fuszenecker/Project1/README.md

# Project1

Project 1 in Kandó College (2007)
Switching mode power supply with ARM microcontroller and Linux.
