fuszenecker/Project1/Prez.pdf

Bevezetés | Hardver | Fejlesztői környezet | Felhasználói felületek | Utószó

## Kapcsoló üzemű tápegység megvalósítása ARM alapú mikrovezérlővel és Linux-szal

Fuszenecker Róbert

Budapesti Műszaki Főiskola Kandó Kálmán Műszaki Főiskolai Kar

2007. december 5.

Fuszenecker Róbert | BMF KKMFK (2007.)

Kapcsoló üzemű tápegység megvalósítása ARM alapú mikrovezérlővel és Linux-szal

## A tápegység főbb tulajdonságai

I Szekunder oldali kapcsoló üzemű működés
I Maximális bemenő feszültség: 16 V
I Kimeneti feszültségtartomány: 0 – 16 V
I Maximális kimenő áram: 1 A (szoftveres áramhatárolással) I 3 db független csatorna
I ARM7TDMI processzor (32 bites)
I Hálózatba szervezhető (RS-232 gyűrű)

## A tápegység főbb tulajdonságai

I Szekunder oldali kapcsoló üzemű működés
I Maximális bemenő feszültség: 16 V
I Kimeneti feszültségtartomány: 0 – 16 V
I Maximális kimenő áram: 1 A (szoftveres áramhatárolással) I 3 db független csatorna
I ARM7TDMI processzor (32 bites)
I Hálózatba szervezhető (RS-232 gyűrű)

## A tápegység főbb tulajdonságai

I Szekunder oldali kapcsoló üzemű működés
I Maximális bemenő feszültség: 16 V
I Kimeneti feszültségtartomány: 0 – 16 V
I Maximális kimenő áram: 1 A (szoftveres áramhatárolással) I 3 db független csatorna
I ARM7TDMI processzor (32 bites)
I Hálózatba szervezhető (RS-232 gyűrű)

## A tápegység főbb tulajdonságai

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

## A tápegység főbb tulajdonságai

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

## A tápegység főbb tulajdonságai

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

## A tápegység főbb tulajdonságai

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

## Hálózat

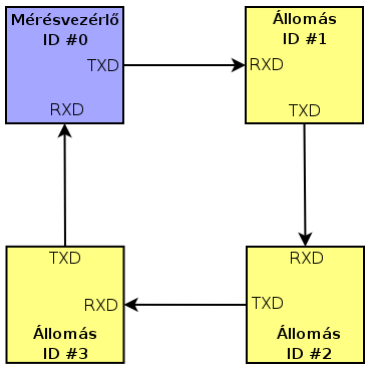
[picture p9: figure]

## A mérőhálózat és a berendezések főbb összetevői

I Mérésvezérlő: személyi számítógép Linux-szal és a megfelelő működtető szoftverrel
I Műszerek felépítése:
I | Processzor modul (mikrovezérlő és kisegítő áramkörei), ez
| tartja a kapcsolatot a mérésvezérlővel
I | Végrehajtó, beavatkozó és érzékelő szerveket tartalmazó modul

## A mérőhálózat és a berendezések főbb összetevői

I Mérésvezérlő: személyi számítógép Linux-szal és a megfelelő működtető szoftverrel
I Műszerek felépítése:
I | Processzor modul (mikrovezérlő és kisegítő áramkörei), ez
| tartja a kapcsolatot a mérésvezérlővel
I | Végrehajtó, beavatkozó és érzékelő szerveket tartalmazó modul

## A mérőhálózat és a berendezések főbb összetevői

I Mérésvezérlő: személyi számítógép Linux-szal és a megfelelő működtető szoftverrel
I Műszerek felépítése:
I | Processzor modul (mikrovezérlő és kisegítő áramkörei), ez
| tartja a kapcsolatot a mérésvezérlővel
I | Végrehajtó, beavatkozó és érzékelő szerveket tartalmazó modul

## A mérőhálózat és a berendezések főbb összetevői

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

## A mérőberendezés blokkvázlata

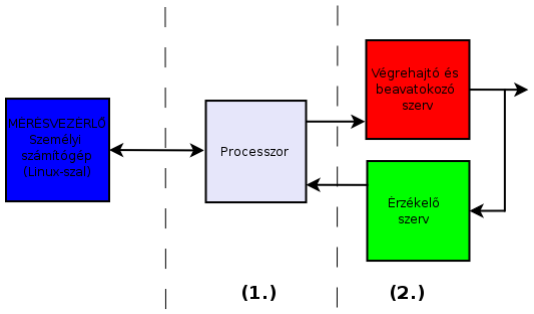
[picture p10: figure]

## Elvárások a mérésvezérlővel szemben

I Operációs rendszer (Linux) és működtető (felhasználói) szoftver
I Párhuzamos (nyomtató) vagy USB csatlakozó a JTAG-hez I Soros port vagy USB → soros port átalakító

A működtető szoftverről még a „Fejlesztői környezet” részben lesz szó.

## Elvárások a mérésvezérlővel szemben

I Operációs rendszer (Linux) és működtető (felhasználói) szoftver
I Párhuzamos (nyomtató) vagy USB csatlakozó a JTAG-hez I Soros port vagy USB → soros port átalakító

A működtető szoftverről még a „Fejlesztői környezet” részben lesz szó.

## Elvárások a mérésvezérlővel szemben

I Operációs rendszer (Linux) és működtető (felhasználói) szoftver
I Párhuzamos (nyomtató) vagy USB csatlakozó a JTAG-hez I Soros port vagy USB → soros port átalakító

A működtető szoftverről még a „Fejlesztői környezet” részben lesz szó.

## Elvárások a mérésvezérlővel szemben

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

A működtető szoftverről még a „Fejlesztői környezet” részben lesz szó.

## Az ARM alapú mikrovezérlők

I Eredetileg az ARM magot processzorok számára fejlesztették ki (Acorn PC-k, Apple iPod, Intel PDA-k)
I Mára a mikrovezérlő-gyártók kedvelt processzora lett
I | 32 bites aritmetikai egységgel rendelkezik
I | 4 GBájt lineáris címtartomány
I | Kis fogyasztás (29,4 mA áramfelvétel 50 MHz-es
| órajelfrekvencián)
I | A gyártók nagyszámú külső eszközzel egészítették ki, így
| alakult ki a mikrovezérlő, az egy lapkán felépített
| számítógép

## Az ARM alapú mikrovezérlők

I Eredetileg az ARM magot processzorok számára fejlesztették ki (Acorn PC-k, Apple iPod, Intel PDA-k)
I Mára a mikrovezérlő-gyártók kedvelt processzora lett
I | 32 bites aritmetikai egységgel rendelkezik
I | 4 GBájt lineáris címtartomány
I | Kis fogyasztás (29,4 mA áramfelvétel 50 MHz-es
| órajelfrekvencián)
I | A gyártók nagyszámú külső eszközzel egészítették ki, így
| alakult ki a mikrovezérlő, az egy lapkán felépített
| számítógép

## Az ARM alapú mikrovezérlők

I Eredetileg az ARM magot processzorok számára fejlesztették ki (Acorn PC-k, Apple iPod, Intel PDA-k)
I Mára a mikrovezérlő-gyártók kedvelt processzora lett
I | 32 bites aritmetikai egységgel rendelkezik
I | 4 GBájt lineáris címtartomány
I | Kis fogyasztás (29,4 mA áramfelvétel 50 MHz-es
| órajelfrekvencián)
I | A gyártók nagyszámú külső eszközzel egészítették ki, így
| alakult ki a mikrovezérlő, az egy lapkán felépített
| számítógép

## Az ARM alapú mikrovezérlők

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

## Az ARM alapú mikrovezérlők

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

## Az ARM alapú mikrovezérlők

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

## Az ARM alapú mikrovezérlők kiegészítő elemei

I FLASH és RAM memória (8-512 kbájt)
I Analóg–digitális és digitális–analóg átalakító (10 bites)
I 16 és 32 bites számlálók (események számlálására, időzítésre, PWM-re)
I SPI: Serial Peripheral Interface, MMC és SD kártyák programozására
I Megszakításvezérlő
I Órajel-generátor

I GPIO: általános célú (digitális) adatbemenetek és kimenetek I RTC: valós idejű óra
I WDT: watchdog timer

## Az ARM alapú mikrovezérlők kiegészítő elemei

I FLASH és RAM memória (8-512 kbájt)
I Analóg–digitális és digitális–analóg átalakító (10 bites)
I 16 és 32 bites számlálók (események számlálására, időzítésre, PWM-re)
I SPI: Serial Peripheral Interface, MMC és SD kártyák programozására
I Megszakításvezérlő
I Órajel-generátor

I GPIO: általános célú (digitális) adatbemenetek és kimenetek I RTC: valós idejű óra
I WDT: watchdog timer

## Az ARM alapú mikrovezérlők kiegészítő elemei

I FLASH és RAM memória (8-512 kbájt)
I Analóg–digitális és digitális–analóg átalakító (10 bites)
I 16 és 32 bites számlálók (események számlálására, időzítésre, PWM-re)
I SPI: Serial Peripheral Interface, MMC és SD kártyák programozására
I Megszakításvezérlő
I Órajel-generátor

I GPIO: általános célú (digitális) adatbemenetek és kimenetek I RTC: valós idejű óra
I WDT: watchdog timer

## Az ARM alapú mikrovezérlők kiegészítő elemei

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

## Az ARM alapú mikrovezérlők kiegészítő elemei

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

## Az ARM alapú mikrovezérlők kiegészítő elemei

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

## Az ARM alapú mikrovezérlők kiegészítő elemei

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

## Az ARM alapú mikrovezérlők kiegészítő elemei

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

## Az ARM alapú mikrovezérlők kiegészítő elemei

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

## Az ARM alapú mikrovezérlők kiegészítő elemei (folytatás)

I U(S)ART: univerzális aszinkron (soros) adó-vevő; ezt fogjuk a számítógéppel való kommunikációhoz használni
I USB: univerzális soros busz
I Ethernet
I CAN és LIN busz: mikrovezérlők helyi hálózatba kötésére

## Az ARM alapú mikrovezérlők kiegészítő elemei (folytatás)

I U(S)ART: univerzális aszinkron (soros) adó-vevő; ezt fogjuk a számítógéppel való kommunikációhoz használni
I USB: univerzális soros busz
I Ethernet
I CAN és LIN busz: mikrovezérlők helyi hálózatba kötésére

## Az ARM alapú mikrovezérlők kiegészítő elemei (folytatás)

I U(S)ART: univerzális aszinkron (soros) adó-vevő; ezt fogjuk a számítógéppel való kommunikációhoz használni
I USB: univerzális soros busz
I Ethernet
I CAN és LIN busz: mikrovezérlők helyi hálózatba kötésére

## Az ARM alapú mikrovezérlők kiegészítő elemei (folytatás)

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

## A választás

A tápegység megépítéséhez az ATMEL cég AT91SAM7S64 típusú mikrovezérlőjét használtam.

## A processzor modul

A processzor modul tartalmaz
I stabilizált, túlfeszültség ellen védett tápegységet, max. 15 V bemenő feszültségig
I nagypontosságú órajelforrást a pontos időzítésekhez, aszinkron soros átvitelhez
I a JTAG kivezetéseket, 10 pólusú szalagkábel csatlakozón keresztül
I a megfelelő üzemmódba lépést beállító kapocspárt (nyomkövetés vagy normál üzem)
I hardver RESET kivezetést a mikrovezérlő esetleges kézi újraindításához
I LED-eket a hibás és megfelelő állapotok jerlzésére

## A processzor modul

A processzor modul tartalmaz
I stabilizált, túlfeszültség ellen védett tápegységet, max. 15 V bemenő feszültségig
I nagypontosságú órajelforrást a pontos időzítésekhez, aszinkron soros átvitelhez
I a JTAG kivezetéseket, 10 pólusú szalagkábel csatlakozón keresztül
I a megfelelő üzemmódba lépést beállító kapocspárt (nyomkövetés vagy normál üzem)
I hardver RESET kivezetést a mikrovezérlő esetleges kézi újraindításához
I LED-eket a hibás és megfelelő állapotok jerlzésére

## A processzor modul

A processzor modul tartalmaz
I stabilizált, túlfeszültség ellen védett tápegységet, max. 15 V bemenő feszültségig
I nagypontosságú órajelforrást a pontos időzítésekhez, aszinkron soros átvitelhez
I a JTAG kivezetéseket, 10 pólusú szalagkábel csatlakozón keresztül
I a megfelelő üzemmódba lépést beállító kapocspárt (nyomkövetés vagy normál üzem)
I hardver RESET kivezetést a mikrovezérlő esetleges kézi újraindításához
I LED-eket a hibás és megfelelő állapotok jerlzésére

## A processzor modul

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

## A processzor modul

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

## A processzor modul

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

## A processzor modul

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

## A processzor modul

A processzor modull tartalmaz (folytatás)
I (Token Ring–)RS-232 kommunikációt lehetővé tevő kivezetéseket és illesztő áramköröket
I 4 pólusú szalagkábel csatlakozóra kivezetett ki- és bemeneteket:
I | 3 db PWM kimenet
I | 2 × 3 db analóg bemenet
I | 3 × 2 db LED kimenet (előlapra kivezetve)

## A processzor modul

A processzor modull tartalmaz (folytatás)
I (Token Ring–)RS-232 kommunikációt lehetővé tevő kivezetéseket és illesztő áramköröket
I 4 pólusú szalagkábel csatlakozóra kivezetett ki- és bemeneteket:
I | 3 db PWM kimenet
I | 2 × 3 db analóg bemenet
I | 3 × 2 db LED kimenet (előlapra kivezetve)

## A processzor modul

A processzor modull tartalmaz (folytatás)
I (Token Ring–)RS-232 kommunikációt lehetővé tevő kivezetéseket és illesztő áramköröket
I 4 pólusú szalagkábel csatlakozóra kivezetett ki- és bemeneteket:
I | 3 db PWM kimenet
I | 2 × 3 db analóg bemenet
I | 3 × 2 db LED kimenet (előlapra kivezetve)

## A processzor modul

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

## A processzor modul

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

## A processzor modul

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

## A processzor modul kapcsolási rajza

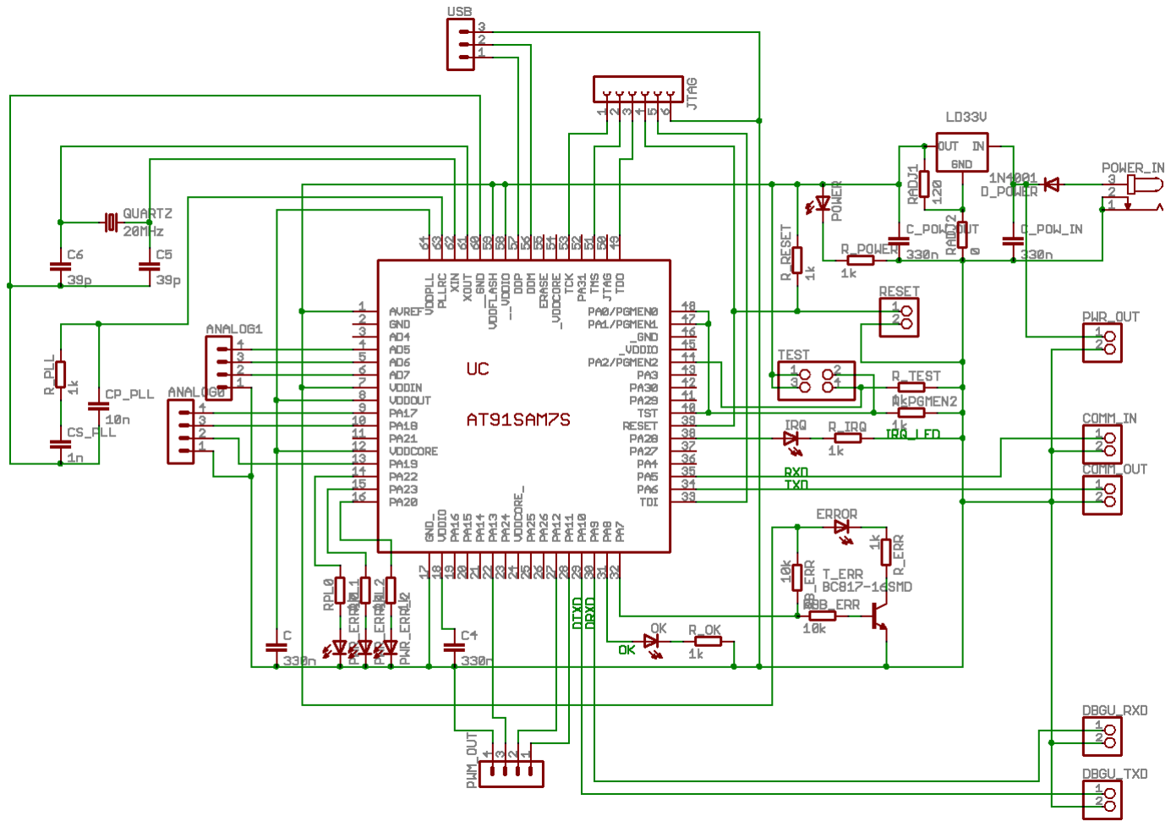
[picture p11: figure]

## A processzor modul NYÁK-rajza


## Érzékelő, végrehajtó és beavatkozó szervek

A modulon kaptak helyet
I A kapcsolóeszközök (PWM jellel vezérelve)
I Kimenő jelek mérésére szolgáló elemek (A/D átalakító segítségével, túlfeszültség-védetten)

## Érzékelő, végrehajtó és beavatkozó szervek

A modulon kaptak helyet
I A kapcsolóeszközök (PWM jellel vezérelve)
I Kimenő jelek mérésére szolgáló elemek (A/D átalakító segítségével, túlfeszültség-védetten)

## Érzékelő, végrehajtó és beavatkozó szervek

A modulon kaptak helyet
I A kapcsolóeszközök (PWM jellel vezérelve)
I Kimenő jelek mérésére szolgáló elemek (A/D átalakító segítségével, túlfeszültség-védetten)

## A végrehajtó-érzékelő modul kapcsolási rajza

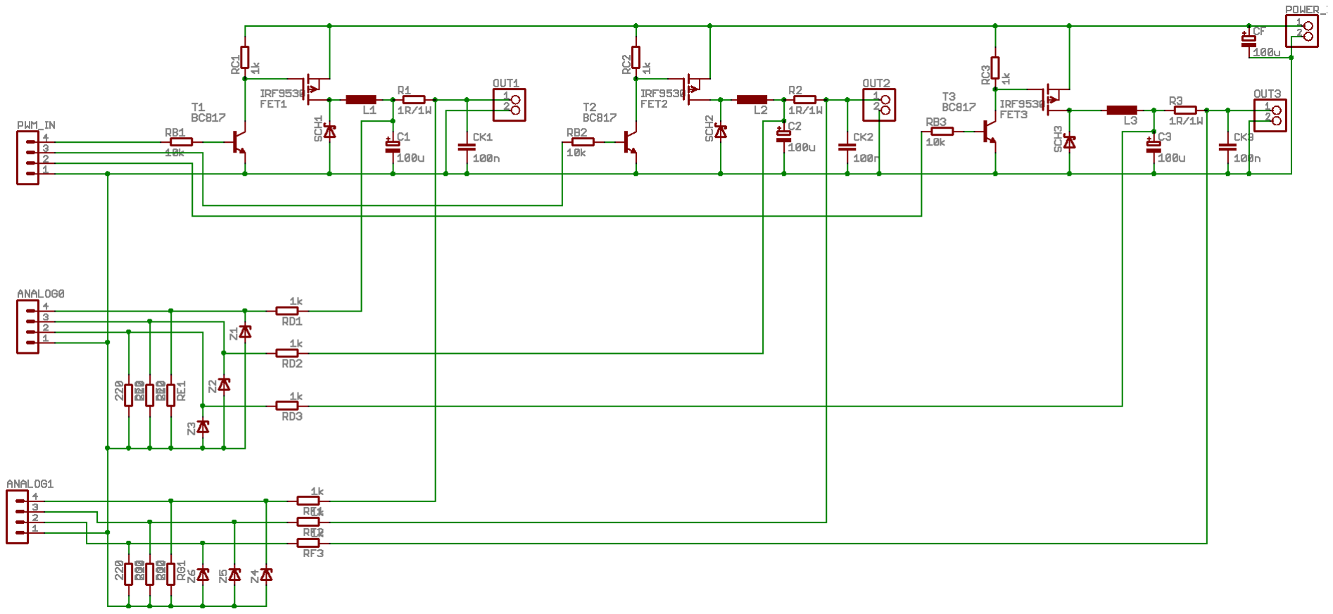
[picture p12: figure]

## A végrehajtó-érzékelő modul NYÁK-rajza


## A fejlesztői környezet

A számítógép működtető szoftverének, és a mikrovezérlő programjának elkészítéséhez szükségesek a következő komponensek:¹

I binutils, gcc és gdb: a számítógép számára fordítanak, ezekkel készül a mérésvezérlő szoftvere
I binutils, gcc és gdb: ARM architektúrára fordítanak; segítségükkel állítjuk elő a mikrovezérlő programját (firmware) I OpenOCD: a számítógépen fut, feltöltő és nyomkövető program

1Erről részletesen a dolgozatban olvashatunk

## A fejlesztői környezet

A számítógép működtető szoftverének, és a mikrovezérlő programjának elkészítéséhez szükségesek a következő komponensek:¹

I binutils, gcc és gdb: a számítógép számára fordítanak, ezekkel készül a mérésvezérlő szoftvere
I binutils, gcc és gdb: ARM architektúrára fordítanak; segítségükkel állítjuk elő a mikrovezérlő programját (firmware) I OpenOCD: a számítógépen fut, feltöltő és nyomkövető program

1Erről részletesen a dolgozatban olvashatunk

## A fejlesztői környezet

A számítógép működtető szoftverének, és a mikrovezérlő programjának elkészítéséhez szükségesek a következő komponensek:¹

I binutils, gcc és gdb: a számítógép számára fordítanak, ezekkel készül a mérésvezérlő szoftvere
I binutils, gcc és gdb: ARM architektúrára fordítanak; segítségükkel állítjuk elő a mikrovezérlő programját (firmware) I OpenOCD: a számítógépen fut, feltöltő és nyomkövető program

1Erről részletesen a dolgozatban olvashatunk

## A fejlesztői környezet

A számítógép működtető szoftverének, és a mikrovezérlő programjának elkészítéséhez szükségesek a következő komponensek:¹

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

1Erről részletesen a dolgozatban olvashatunk

## Adatátvitel soros porton keresztül

A számítógép és a mikrovezérlő között az átvitel bájtsoros és csomagorientált. Tulajdonságai:
I Több eszköz (mérésvezérlő és mérőberendezések) kapcsolható rendszerbe
I Fix csomagméret, előre definiált parancsok
I Nincs szükség statikus eszközazonosítókra, ezeket a mérésvezérlő osztja ki
I Hibavédelemmel ellátott a kommunikáció (8 bites ellenőrző összeg)

## Adatátvitel soros porton keresztül

A számítógép és a mikrovezérlő között az átvitel bájtsoros és csomagorientált. Tulajdonságai:
I Több eszköz (mérésvezérlő és mérőberendezések) kapcsolható rendszerbe
I Fix csomagméret, előre definiált parancsok
I Nincs szükség statikus eszközazonosítókra, ezeket a mérésvezérlő osztja ki
I Hibavédelemmel ellátott a kommunikáció (8 bites ellenőrző összeg)

## Adatátvitel soros porton keresztül

A számítógép és a mikrovezérlő között az átvitel bájtsoros és csomagorientált. Tulajdonságai:
I Több eszköz (mérésvezérlő és mérőberendezések) kapcsolható rendszerbe
I Fix csomagméret, előre definiált parancsok
I Nincs szükség statikus eszközazonosítókra, ezeket a mérésvezérlő osztja ki
I Hibavédelemmel ellátott a kommunikáció (8 bites ellenőrző összeg)

## Adatátvitel soros porton keresztül

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

## Adatátvitel soros porton keresztül

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

## Csomagformátum

I (8 bit) Cél eszköz azonosítója (dinamikus) I (8 bit) Parancs kódja
I (8 bit) Adat, paraméter
I (8 bit) Ellenőrző összeg (nullázó bájt)

## A TokenRing–RS-232 hálózat felépítése

## Vezérlő szoftver (felhasználói interfész)

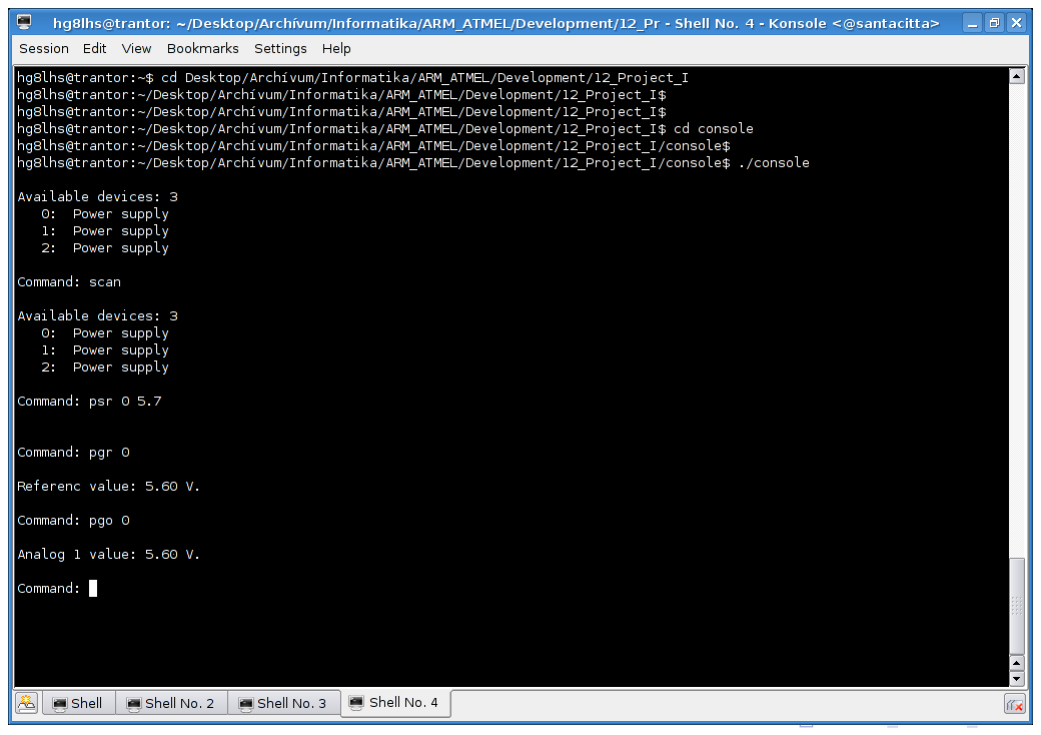
[picture p13: figure]

## Grafikus vezérlő szoftver

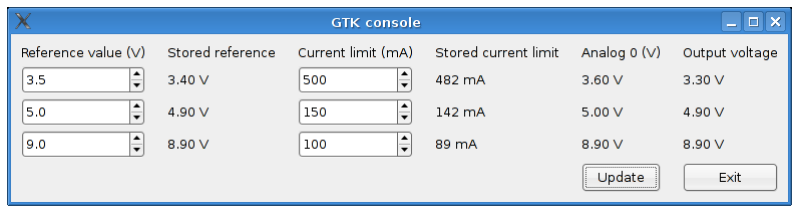
[picture p14: figure]

## Továbbfejlesztési lehetőségek

A dolgozatban megépített áramkör bővíthető, például
I kifinomultabb szabályozással (PID kompenzált, véges beállású, stb.)
I akkumulátor-töltő funkcióval
I pontosabb kimenőáram-méréssel
I további kommunikációs megoldásokkal (LIN, CAN, Ethernet, EtherCAT, GSM) . . .

## Továbbfejlesztési lehetőségek

A dolgozatban megépített áramkör bővíthető, például
I kifinomultabb szabályozással (PID kompenzált, véges beállású, stb.)
I akkumulátor-töltő funkcióval
I pontosabb kimenőáram-méréssel
I további kommunikációs megoldásokkal (LIN, CAN, Ethernet, EtherCAT, GSM) . . .

## Továbbfejlesztési lehetőségek

A dolgozatban megépített áramkör bővíthető, például
I kifinomultabb szabályozással (PID kompenzált, véges beállású, stb.)
I akkumulátor-töltő funkcióval
I pontosabb kimenőáram-méréssel
I további kommunikációs megoldásokkal (LIN, CAN, Ethernet, EtherCAT, GSM) . . .

## Továbbfejlesztési lehetőségek

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

## Továbbfejlesztési lehetőségek

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

# Kérdések?

# Köszönöm a figyelmet!

## Felhasznált irodalom

I ARM7TDMI Technical Reference Manual (Rev 3), ARM Limited, 2001.
I AT91 ARM Thumb-based Microcontrollers, ATMEL Corporation, 2006. november 22.

## Felhasznált szoftverek

I Ubuntu Linux 6.06 (Dapper Drake) [Linux kernel 2.6.15-27-k7] I binutils 2.17 (using BFD version 2.17)
I gcc 4.0.3
I openocd – Open On-Chip Debugger (2007-05-30 17:45 CEST) I VIM — VI IMproved version 6.4.6
I LATEX2ε (pdfeTeX, Version 3.141592-1.21a-2.2)
I The GIMP 2.2.11
I aspell (International Ispell Version 3.1.20 (but really Aspell 0.60.4))
I Dia 0.94
I Eagle 4.16r2 for Linux, Light Edition
