fuszenecker/Project1/Hardware/RS232_pcb.png

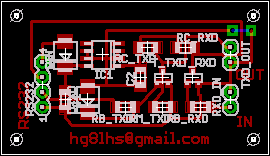
Hardware/RS232_pcb.png
