fuszenecker/Project1/Hardware/RS232_sch.png

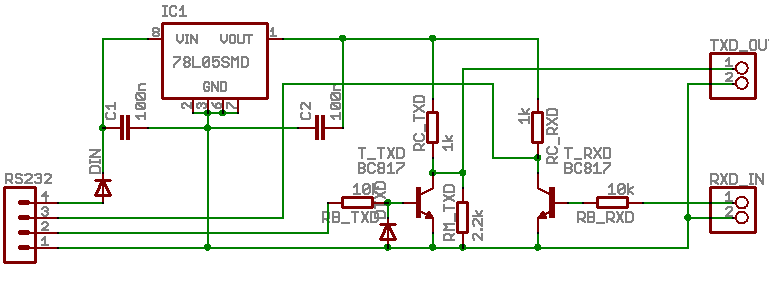
Hardware/RS232_sch.png
