fuszenecker/Project1/Prez/Background.png

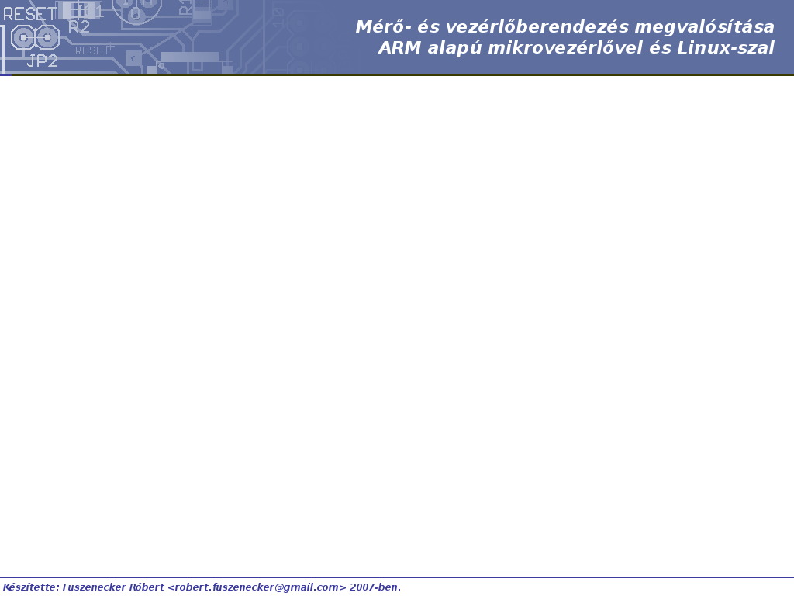
Prez/Background.png
